minodori/spotmicro-pi/study/README.md

# 개발 일지 — 11주

결과물만으로는 전달되지 않는 시행착오의 맥락이 여기 있습니다. 서보를 잘못 고른 일,
전원 설계를 두 번 바꾼 일, 제어보드가 고장나 교체한 일이 그대로 남아 있습니다.

| 폴더 | 기간 | 내용 |
|---|---|---|
| [`minho/`](minho/) | work01~12 | 서보 선정, 조립, 전원 재설계, PCA9685 핀맵, **실측 기반 기구학 정정**, 4B 전환 |

가장 값이 큰 기록은 work10 입니다. 공개 코드의 다리 길이와 실물이 다르다는 것을
캘리퍼스로 확인한 회차이고, 이 저장소가 하는 일의 출발점입니다.

## 함께 작업한 사람들

이 로봇은 스터디에서 시작했습니다. 봄·여름 학기 참여자들의 기구학·보행 작업과
MuJoCo 학습 파이프라인이 기반이 되었습니다. 그 기록은 원 저장소에 있습니다.

- [orocapangyo/SpotMicroJetson](https://github.com/orocapangyo/SpotMicroJetson) — 스터디 저장소

계보와 라이선스 경계는 저장소 최상위 [`NOTICE`](../NOTICE) 에 적었습니다.
