minodori/spotmicro-pi/Images/README.md

# Images — upstream 데모 미디어

이 디렉터리의 사진과 GIF 는 **upstream(Road-Balance / FlorianWilk) 프로젝트의
로봇**을 담은 것으로, 본 팀이 제작한 로봇이 아닙니다. upstream README 가 참조하고
있어 그대로 보존합니다.

**본 팀이 촬영·제작한 미디어는 [`docs/media/`](../docs/media/) 에 있습니다.**
