minodori/spotmicro-pi/docs/media/README.md

# docs/media — 본 팀 로봇 미디어

본 팀이 제작한 로봇의 촬영본과 데모 미디어. `Images/` 의 upstream 데모와 구분됩니다.

대용량 영상은 저장소에 커밋하지 않고 GitHub 이슈에 업로드해 URL 로 참조합니다.
README 상단용 짧은 GIF(3MB 이하)만 여기에 둡니다.
