minodori/spotmicro-pi/docs/media/architecture.png

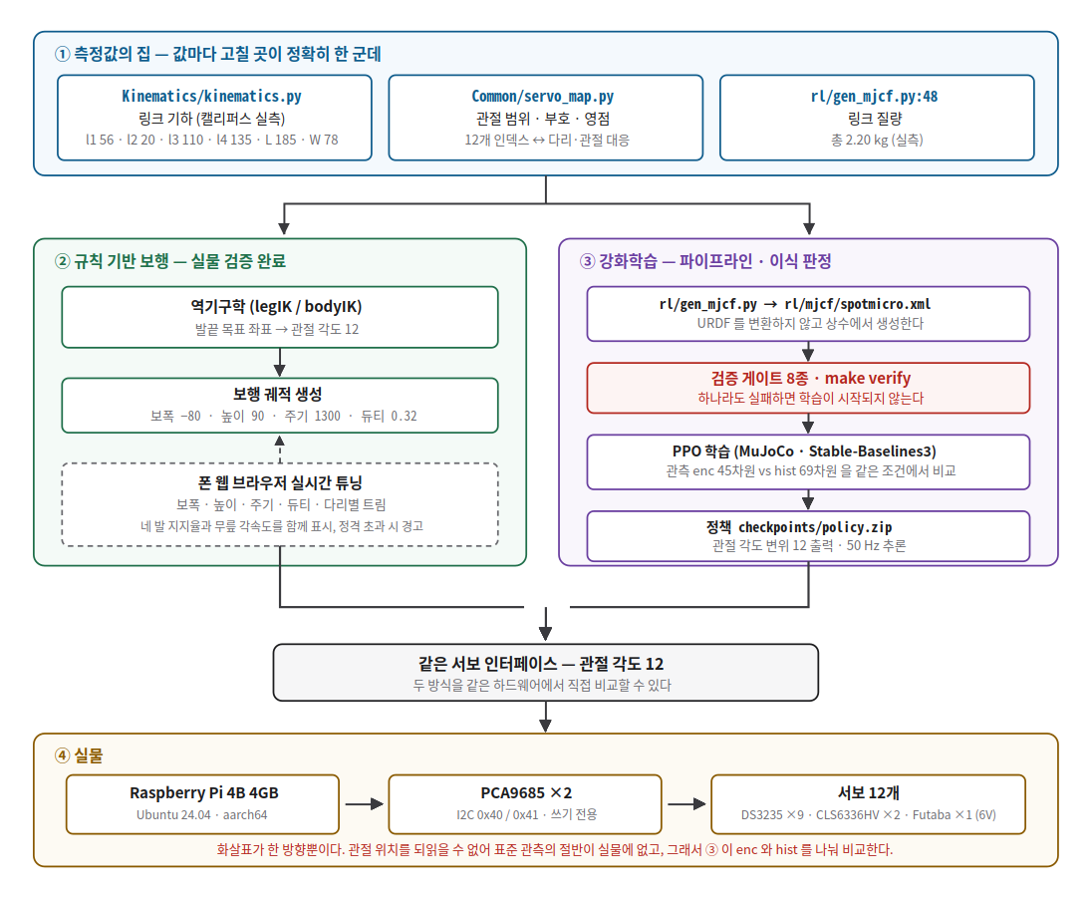
docs/media/architecture.png
