minodori/spotmicro-pi/docs/media/cut3_purpose.png

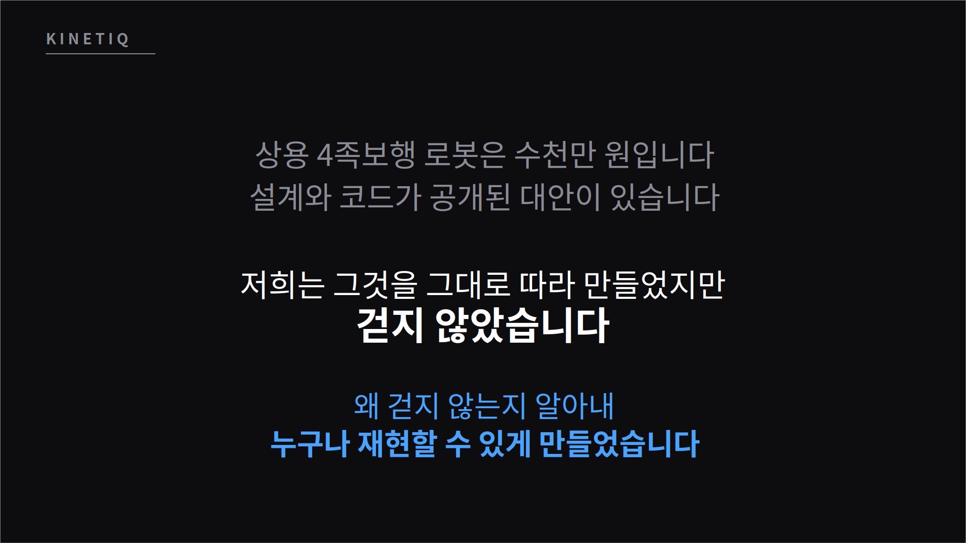
docs/media/cut3_purpose.png
