minodori/spotmicro-pi/docs/media/cut11_pipeline.png

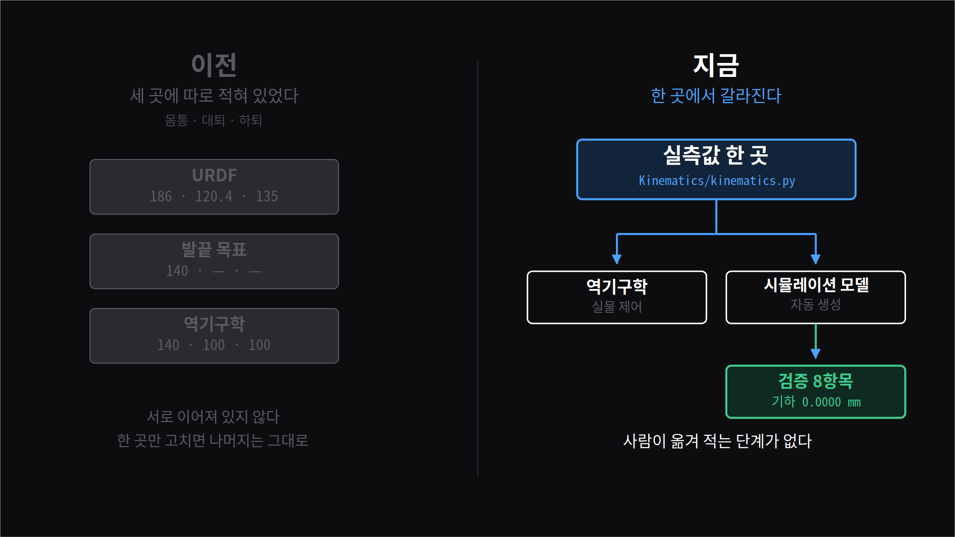
docs/media/cut11_pipeline.png
