minodori/spotmicro-pi/docs/media/cut20_three.png

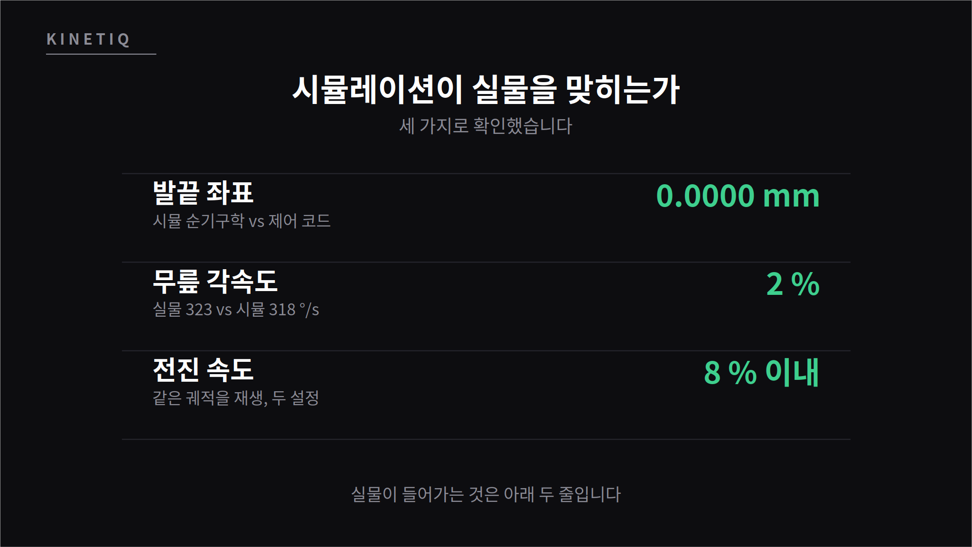
docs/media/cut20_three.png
