minodori/spotmicro-pi/docs/media/cut22_ending.png

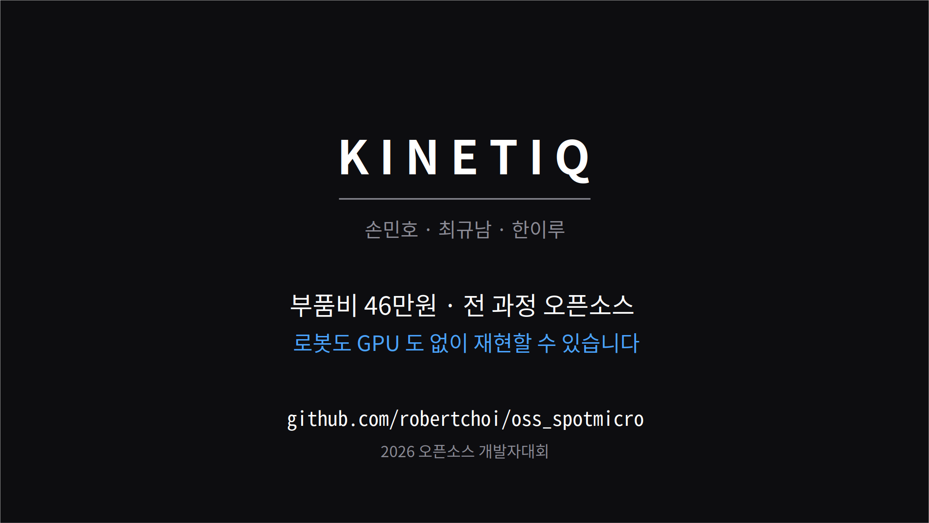
docs/media/cut22_ending.png
