minodori/spotmicro-pi/docs/media/templates/card_kinetiq_bottom.png

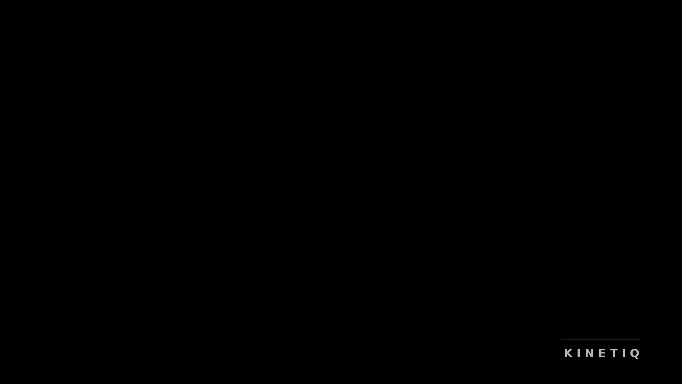
docs/media/templates/card_kinetiq_bottom.png
