minodori/spotmicro-pi/Simulation/image/keyboard_control.gif

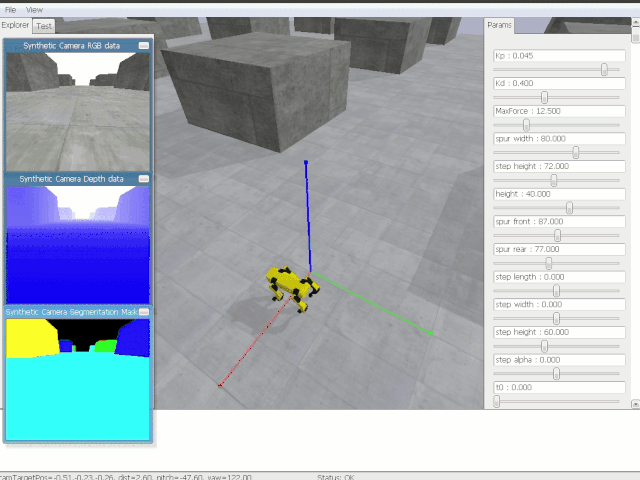
Simulation/image/keyboard_control.gif
