minodori/spotmicro-pi/study/minho/images/diagram_v1.0.png

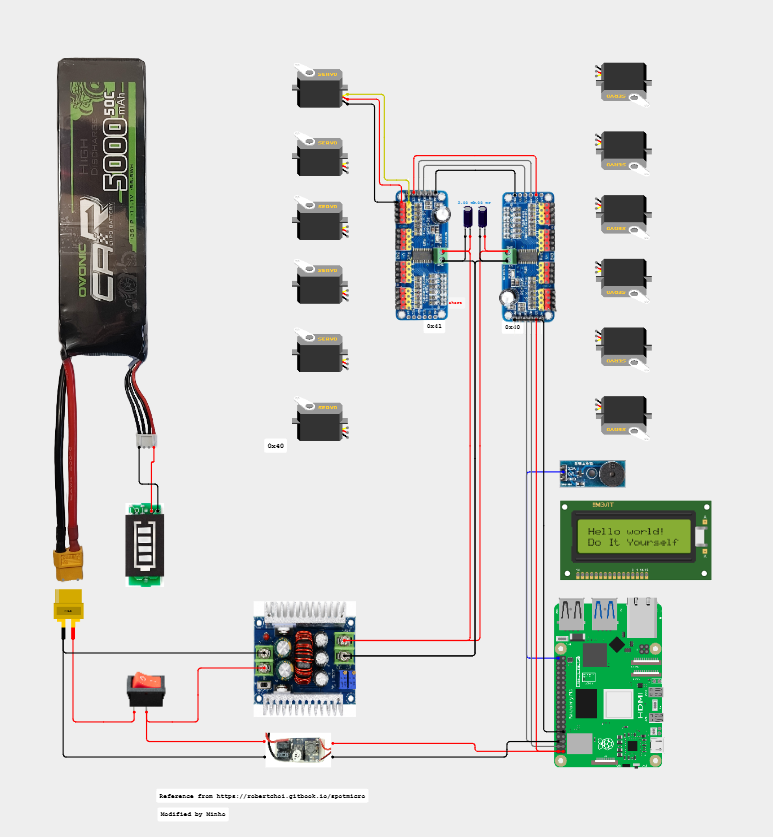
study/minho/images/diagram_v1.0.png
