minodori/spotmicro-pi/study/minho/stl/plate_rpi.png

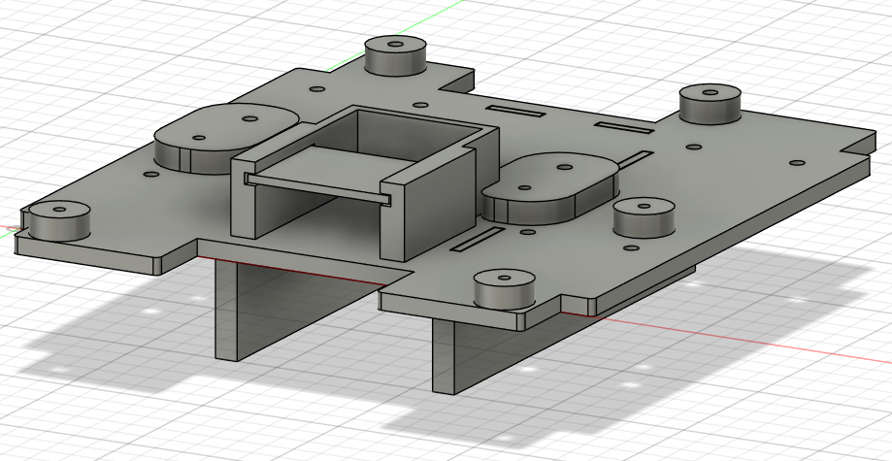
study/minho/stl/plate_rpi.png
