minodori/spotmicro-pi/Parts/rearmain.stl

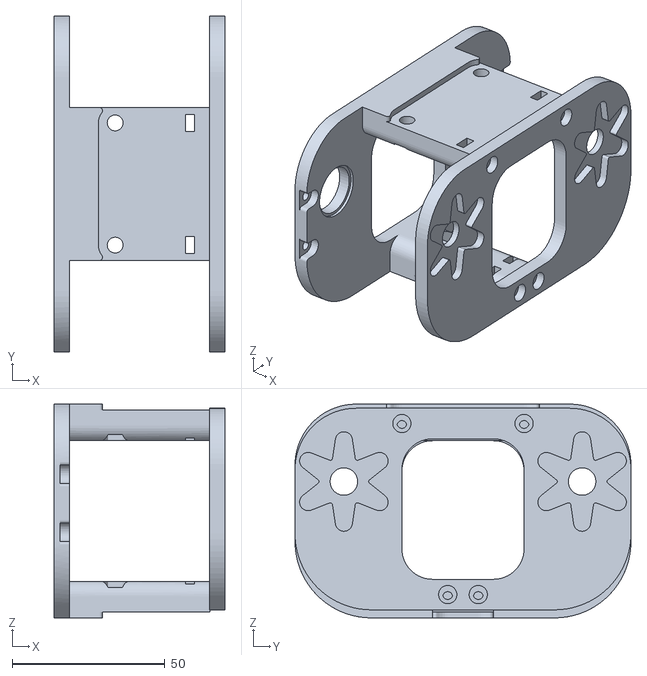
[picture p95: CAD file, 2020-09-26]
Parts/rearmain.stl
55.9 x 110.0 x 70.0
