minodori/spotmicro-pi/STL/lidar/rplidar_main.STL

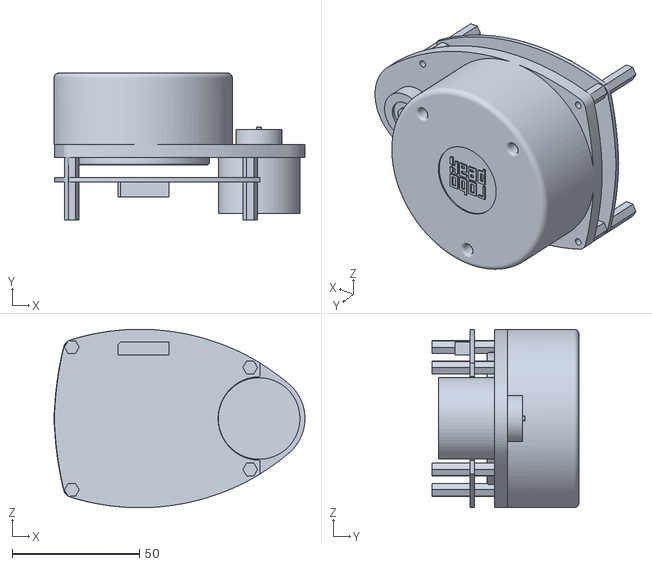
[picture p96: CAD file, 2020-09-26]
STL/lidar/rplidar_main.STL
98.5 x 57.7 x 70.0
