minodori/spotmicro-pi/Parts/mainbody.stl

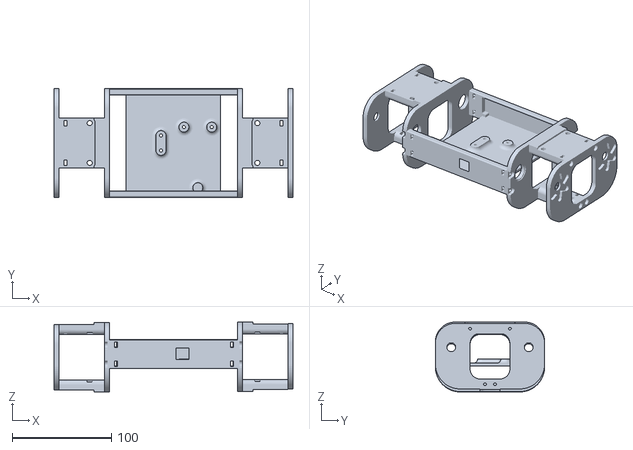
[picture p97: CAD file, 2020-09-26]
Parts/mainbody.stl
240.7 x 110.0 x 70.4
