minodori/spotmicro-pi/STEP_Files/I_shoulder_cls_modi.stp

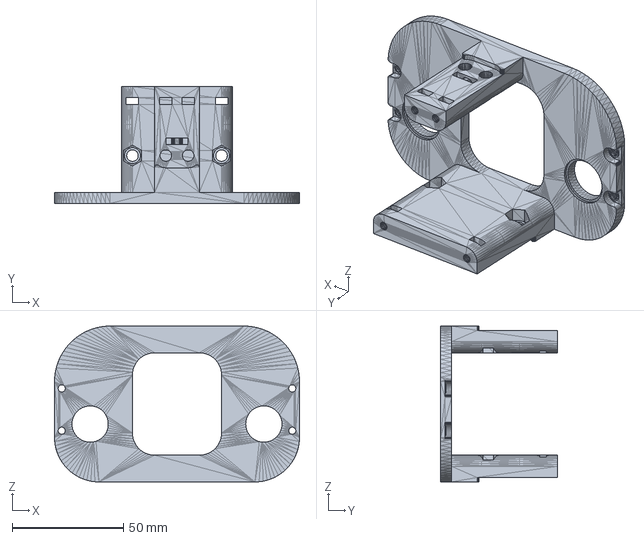
[picture p98: CAD file, 2021-01-22]
STEP_Files/I_shoulder_cls_modi.stp
110.0 x 52.5 x 70.0 mm
