minodori/spotmicro-pi/STL/files/L_arm_joint.3mf

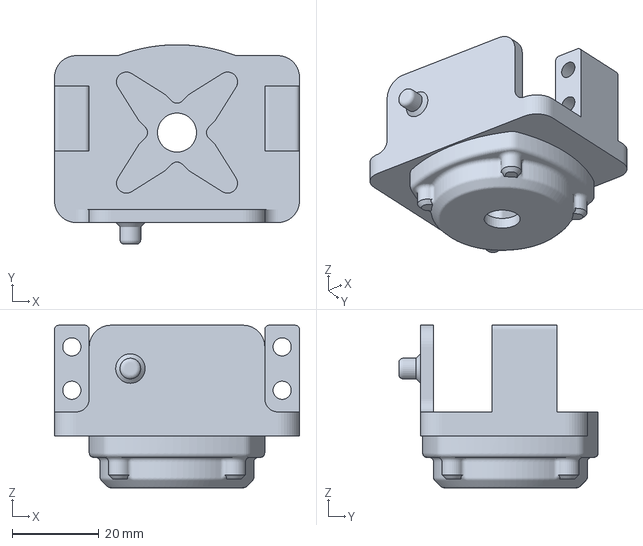
[picture p99: CAD file, 2026-09-12]
STL/files/L_arm_joint.3mf
56.5 x 46.0 x 37.5 mm
