minodori/spotmicro-pi/STL/rear2.stl

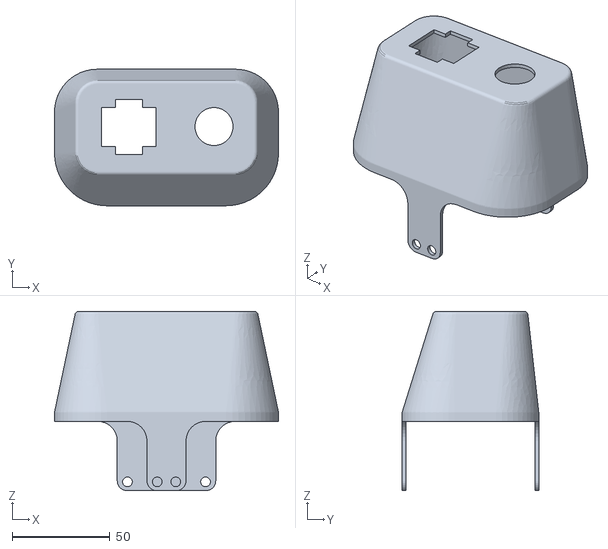
[picture p100: CAD file, 2020-09-26]
STL/rear2.stl
114.8 x 70.0 x 91.9
