minodori/spotmicro-pi/study/minho/stl/plate_ubec.stl

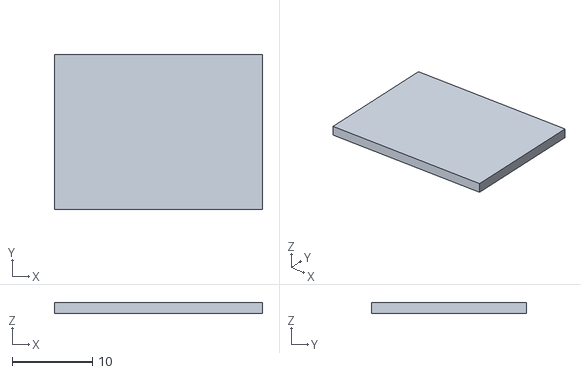
[picture p101: CAD file, 2026-08-20]
study/minho/stl/plate_ubec.stl
26.0 x 19.4 x 1.40
