minodori/spotmicro-pi/urdf/FreeCAD/SpotMicroAI_AdditionalParts.FCStd

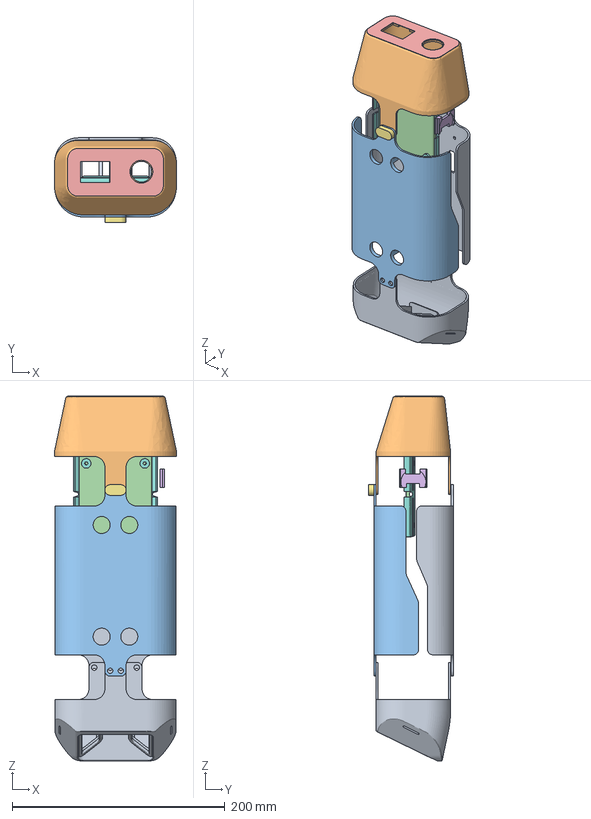
[picture p102: CAD file, 2020-09-26]
urdf/FreeCAD/SpotMicroAI_AdditionalParts.FCStd
114.8 x 79.5 x 343.2 mm
Top
Rear
Bottom
BatteryHolderHolder
rearlabel
LEDMount
ScrewGuard
F_cover
