minodori/spotmicro-pi/Parts/lshoulder.stl

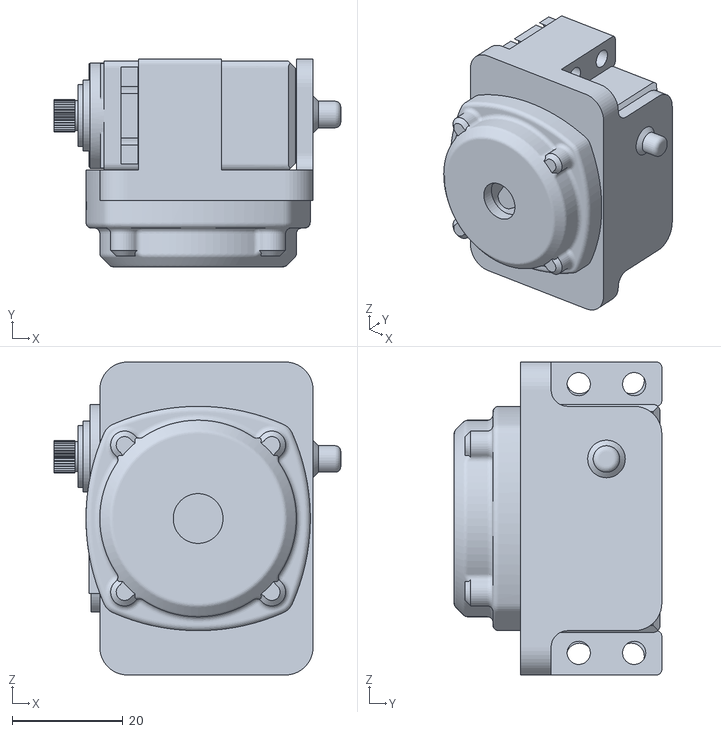
[picture p103: CAD file, 2020-09-26]
Parts/lshoulder.stl
51.7 x 37.5 x 56.5
