minodori/spotmicro-pi/STEP_Files/Bottom_modi(long).stp

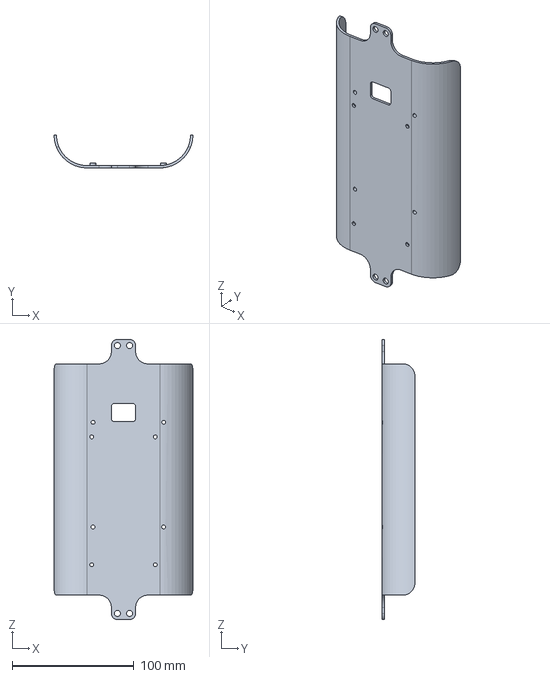
[picture p104: CAD file, 2021-01-22]
STEP_Files/Bottom_modi(long).stp
114.0 x 27.0 x 230.0 mm
