minodori/spotmicro-pi/STL/batteryholder2.stl

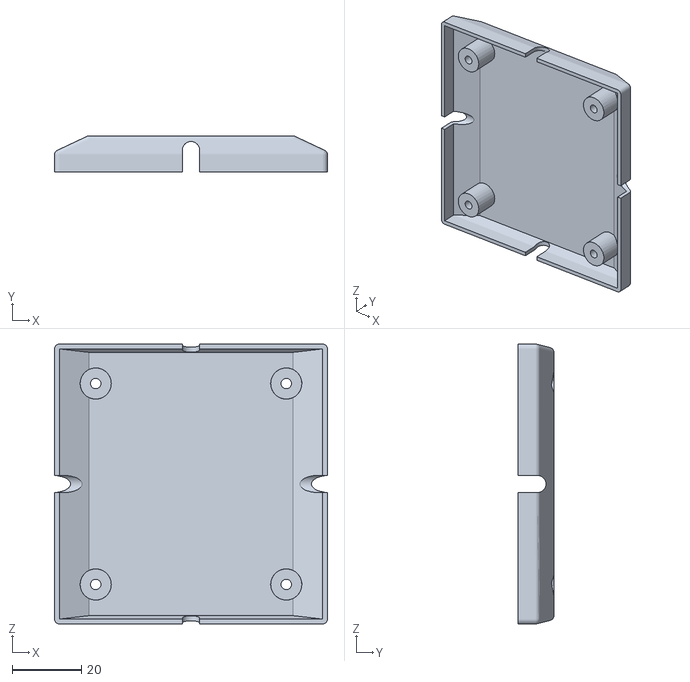
[picture p105: CAD file, 2020-09-26]
STL/batteryholder2.stl
78.8 x 10.4 x 80.8
