minodori/spotmicro-pi/STL/files/R_side_plate.stl

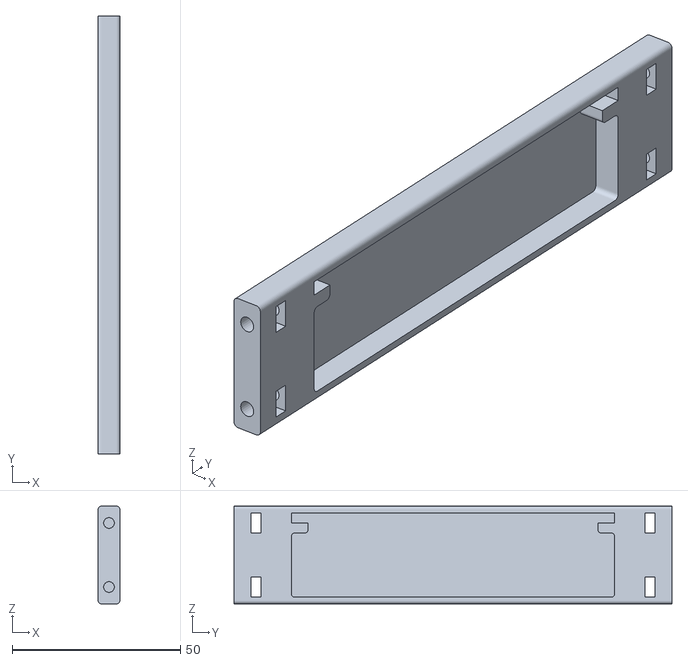
[picture p106: CAD file, 2020-09-26]
STL/files/R_side_plate.stl
6.50 x 130.0 x 29.0
