minodori/spotmicro-pi/study/minho/stl/plate_batt.stl

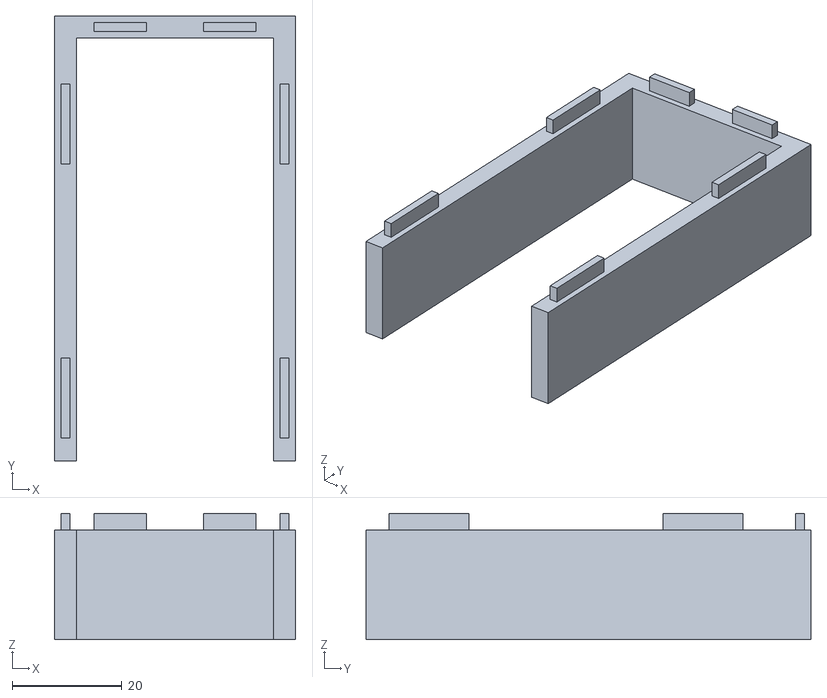
[picture p107: CAD file, 2026-08-20]
study/minho/stl/plate_batt.stl
44.0 x 81.2 x 23.0
