minodori/spotmicro-pi/urdf/FreeCAD/SpotMicroAI_JetsonParts.FCStd

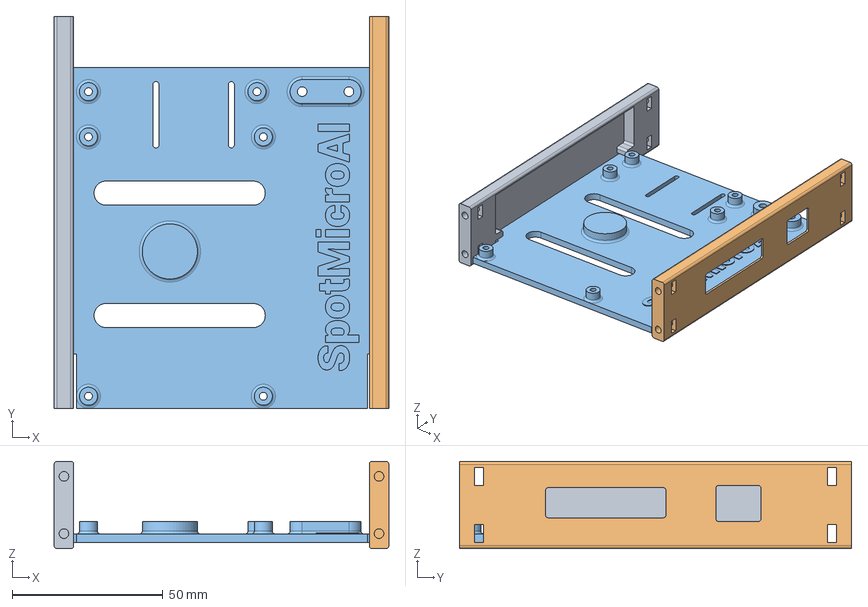
[picture p108: CAD file, 2020-09-26]
urdf/FreeCAD/SpotMicroAI_JetsonParts.FCStd
111.0 x 130.0 x 29.0 mm
rightSideplate
leftSideplate
JetsonPlateWithText
