minodori/spotmicro-pi/Parts/SpotMicroAI_Rear.FCStd

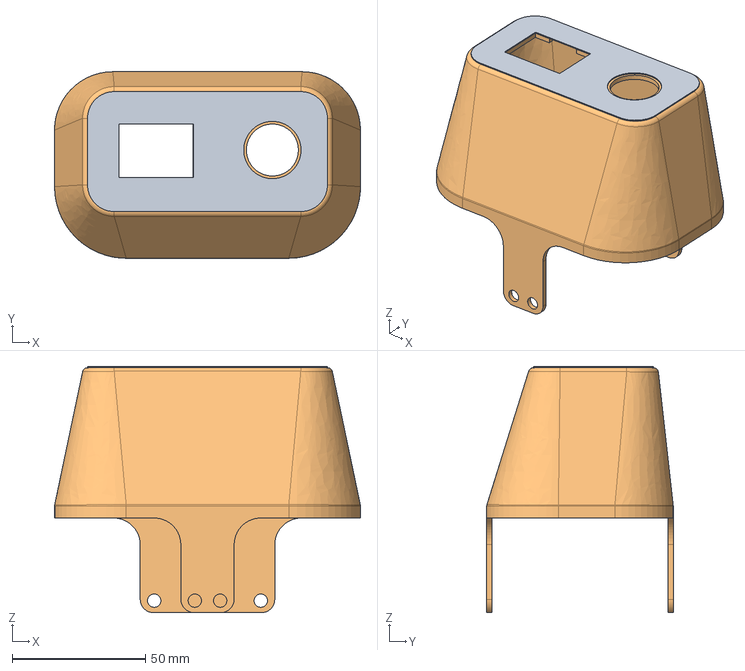
[picture p109: CAD file, 2020-09-26]
Parts/SpotMicroAI_Rear.FCStd
114.8 x 70.0 x 92.4 mm
rearlabel
Rear
