minodori/spotmicro-pi/STEP_Files/Top_modi(long).stp

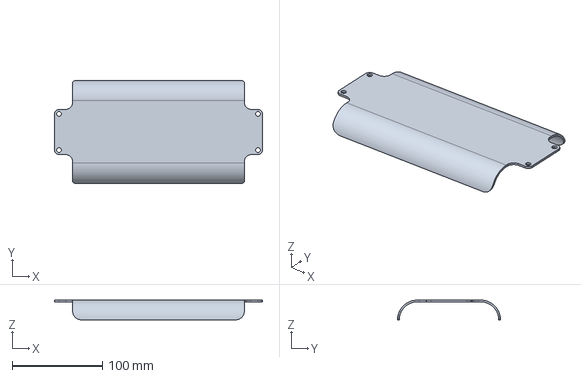
[picture p110: CAD file, 2021-01-22]
STEP_Files/Top_modi(long).stp
230.0 x 114.0 x 22.0 mm
