minodori/spotmicro-pi/STL/files/L_ultra_sonic.stl

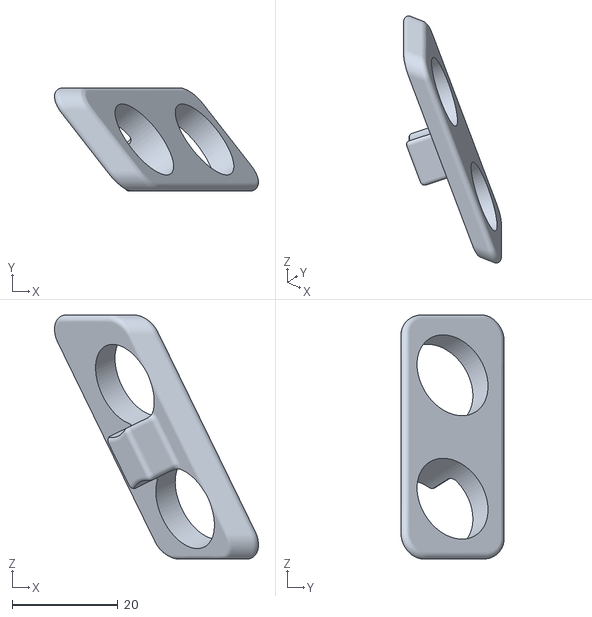
[picture p112: CAD file, 2020-09-26]
STL/files/L_ultra_sonic.stl
38.6 x 19.5 x 46.2
