minodori/spotmicro-pi/study/minho/stl/plate_rpi5.stl

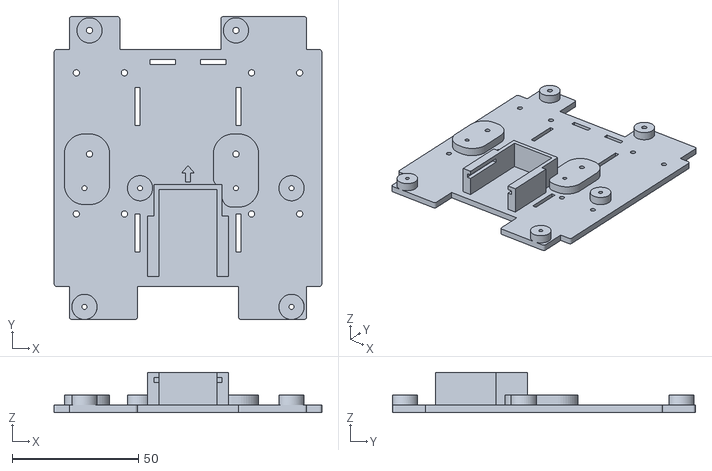
[picture p113: CAD file, 2026-08-20]
study/minho/stl/plate_rpi5.stl
106.0 x 120.0 x 16.0
