minodori/spotmicro-pi/STEP_Files/O_shoulder_cls_grooved_modi.stp

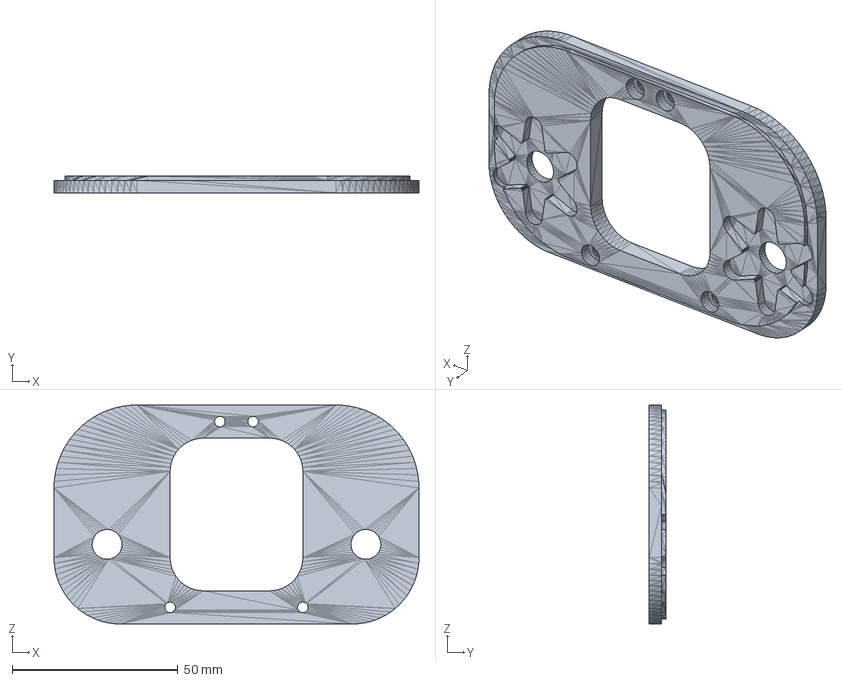
[picture p116: CAD file, 2021-01-22]
STEP_Files/O_shoulder_cls_grooved_modi.stp
110.0 x 5.00 x 66.0 mm
