minodori/spotmicro-pi/STL/top.stl

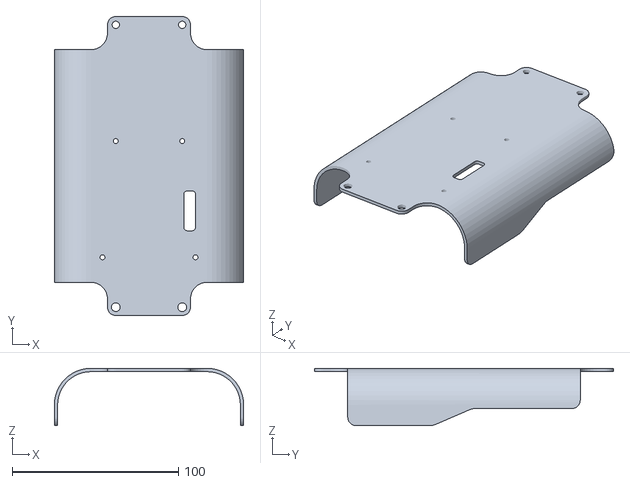
[picture p117: CAD file, 2020-09-26]
STL/top.stl
114.0 x 180.0 x 34.5
