minodori/spotmicro-pi/study/minho/stl/Spot_Stand.stl

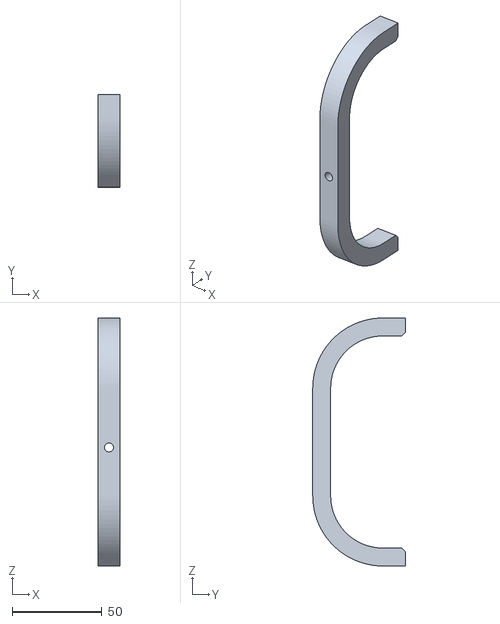
[picture p118: CAD file, 2026-07-01]
study/minho/stl/Spot_Stand.stl
12.0 x 51.5 x 138.0
