minodori/spotmicro-pi/STL/files/plate.stl

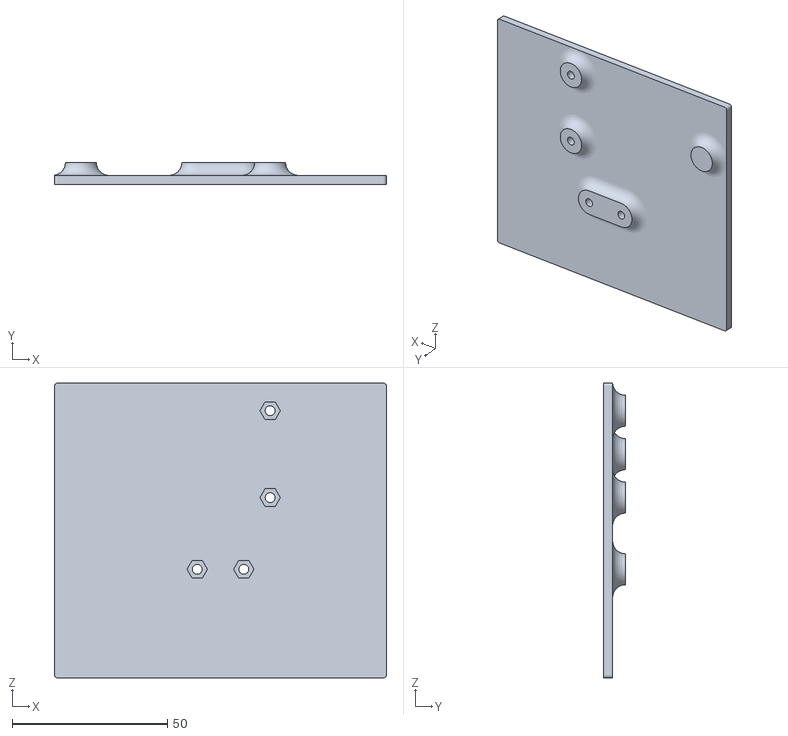
[picture p136: CAD file, 2020-09-26]
STL/files/plate.stl
107.0 x 7.00 x 95.0
