minodori/spotmicro-pi/Parts/jetsonPlate.stl

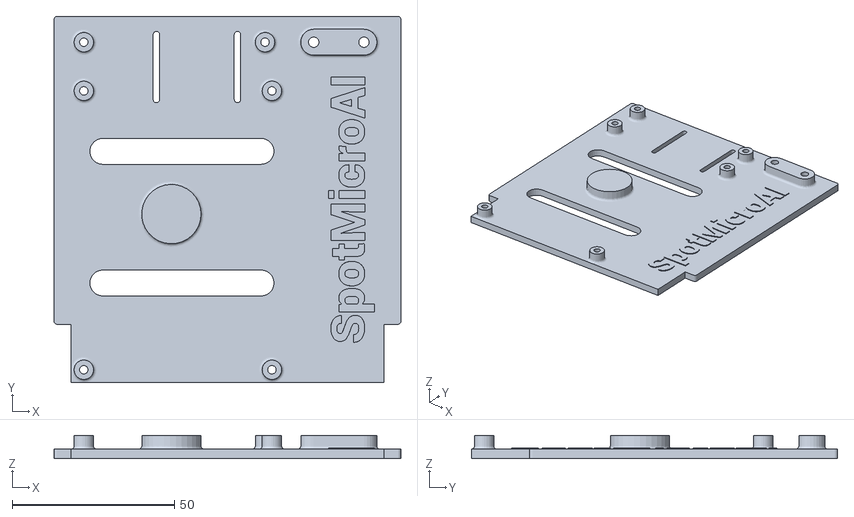
[picture p137: CAD file, 2020-09-26]
Parts/jetsonPlate.stl
107.0 x 113.0 x 7.10
