minodori/spotmicro-pi/(list of files, cad)

Other CAD files:
STL/files/non-mega_L_side_plate.stl
urdf/FreeCAD/SpotMicroAI_Bottom.FCStd
STL/files/R_arm_joint.stl
STL/rear.stl
STL/files/L_side_plate.stl
Parts/larm.stl
STL/files/R_ultra_sonic.stl
Parts/rshoulder.stl
STL/files/T_cover.stl
Parts/rfoot.stl
STL/files/R_wrist.stl
Parts/larm_cover.stl
STL/files/F_cover.stl
Parts/SpotMicroAI_Bottom.FCStd
STL/files/non-mega_B_cover.stl
STL/files/F_shoulder.stl
Parts/spotmicroai.blend
STL/files/L_arm.stl
STL/files/L_arm_cover.stl
STL/files/L_arm_joint.stl
STL/files/R_arm.stl
STL/files/R_arm_cover.stl
STL/files/R_shoulder.stl
STL/screwguard.stl
