minodori/spotmicro-pi/(list of files, drawings)

Other design files:
docs/hardware/circuit_diagram_v1.0.fzz
docs/hardware/circuit_diagram_v1.1.fzz
docs/Untitled Sketch 2.fzz
