minodori/spotmicro-pi/Common/web_control.py

"""보행 파라미터 조정용 웹 UI.

로봇을 보면서 조작해야 하는데 터미널을 동시에 볼 수 없다는 문제를 푼다.
폰으로 http://<로봇IP>:8080 에 접속하면 손에 들고 조작할 수 있다.

제어 루프(39Hz)는 건드리지 않는다. 데몬 스레드로 HTTP 서버를 띄우고
기존 command_status 큐를 키보드 입력과 같이 쓴다.
표준 라이브러리만 사용하므로 로봇에 추가 패키지가 필요 없다.
"""
import json
import subprocess
import threading
from http.server import BaseHTTPRequestHandler, ThreadingHTTPServer

from Common.gait_params import DEFAULTS
from Common.servo_map import SERVO_RATED_SLEW
from Common.multiprocess_kb import TWIST_WARN_RATIO

LEGS = ("FL", "FR", "RL", "RR")

PAGE = """<!doctype html><html lang="ko"><head>
<meta charset="utf-8"><meta name="viewport" content="width=device-width,initial-scale=1">
<title>SpotMicro</title><style>
*{box-sizing:border-box}
body{margin:0;padding:10px;font:15px/1.4 system-ui,sans-serif;background:#15171c;color:#e8e8ea}
h2{margin:4px 0 10px;font-size:16px;font-weight:600}
.grid{display:grid;grid-template-columns:1fr 1fr;gap:8px;margin-bottom:12px}
.leg{background:#22252c;border-radius:10px;padding:10px;text-align:center}
.leg .n{font-size:12px;color:#9aa0aa}
.leg .v{font-size:26px;font-weight:700;margin:2px 0 6px;font-variant-numeric:tabular-nums}
button{font:inherit;color:#e8e8ea;background:#333842;border:0;border-radius:8px;
 padding:12px 0;width:46%;font-size:19px;font-weight:700;cursor:pointer;touch-action:manipulation}
button:active{background:#4a5261}
.row{display:flex;gap:8px;align-items:center;margin:8px 0}
.row label{width:74px;color:#9aa0aa;font-size:13px}
.row input[type=range]{flex:1}
.row .rv{width:56px;text-align:right;font-variant-numeric:tabular-nums}
.bar{display:flex;gap:8px;margin:10px 0}
.bar button{width:auto;flex:1;padding:14px 0}
.pad{display:grid;grid-template-columns:1fr 1fr 1fr;gap:8px;margin:10px 0}
.pad button{width:100%;padding:16px 0;font-size:17px}
.stop{background:#7a2b2b}
.warn{background:#6b4a13;border-radius:8px;padding:8px;margin:8px 0;font-size:13px;display:none}
.hint{color:#7d838d;font-size:12px;margin:-4px 0 10px 82px}
.hint2{color:#7d838d;font-size:12px;margin:-4px 0 10px 2px}
.sub{font-weight:400;color:#9aa0aa;font-size:13px}
.st{background:#22252c;border-radius:10px;padding:10px;font-size:13px;color:#9aa0aa}
.st b{color:#e8e8ea;font-variant-numeric:tabular-nums}
.sw{position:fixed;right:10px;bottom:10px;background:#22252c;border:1px solid #333842;
 border-radius:12px;padding:8px 12px;text-align:right;cursor:pointer;
 box-shadow:0 2px 12px rgba(0,0,0,.5);touch-action:manipulation;z-index:9}
.sw .t{font-size:30px;font-weight:700;font-variant-numeric:tabular-nums;line-height:1.05}
.sw .d{font-size:11px;color:#7d838d;margin-top:2px}
.sw.run .t{color:#6bc47d}
</style></head><body>

<h2>다리별 트림 (mm)</h2>
<div class="grid" id="legs"></div>
<div class="warn" id="warn"></div>

<h2>기울기 <span class="sub" id="tilt"></span></h2>
<div class="bar">
 <button onclick="cmd({mode:'pitch',delta:1})">앞으로 숙임</button>
 <button onclick="cmd({mode:'pitch',delta:-1})">뒤로 젖힘</button>
</div>
<div class="hint2">무게중심이 뒤로 쏠려 있으면 앞으로 숙여 앞다리에 하중을 옮긴다. 1mm 당 약 0.7%p.</div>
<div class="bar">
 <button onclick="cmd({mode:'roll',delta:1})">왼쪽 낮춤</button>
 <button onclick="cmd({mode:'roll',delta:-1})">오른쪽 낮춤</button>
</div>

<div class="bar">
 <button onclick="cmd({reset:'trim'})">트림 0 으로</button>
 <button onclick="cmd({reset:'all'})">전체 기본값</button>
</div>

<div class="row"><label>몸통 높이</label>
 <input type="range" id="height" step="1"><span class="rv" id="heightv"></span></div>
<div class="hint">어깨축~발바닥 = 140 + 이 값. 무릎내각 110도가 96, 120도가 108, 130도가 118.</div>
<div class="row"><label>발 들어올림</label>
 <input type="range" id="Sh" step="1"><span class="rv" id="Shv"></span></div>
<div class="hint">스윙 중 발이 지면에서 뜨는 높이. 작으면 발이 끌리고, 크면 무릎이 궤적을 못 따라간다.</div>
<div class="row"><label>주기</label>
 <input type="range" id="Tt" step="50"><span class="rv" id="Ttv"></span></div>
<div class="hint">한 걸음 주기(ms). 전진 속도 = 보폭 / 주기 이므로 이것만 속도를 정한다.</div>
<div class="row"><label>스윙 비율</label>
 <input type="range" id="duty" step="0.01"><span class="rv" id="dutyv"></span></div>
<div class="hint">주기 중 발이 떠 있는 비율. 이것만 네발지지를 정한다 (= 1 − 2 × 비율).
 <b>올리지 마세요.</b> 0.21(네발지지 58%)에서 뒤로 넘어진 기록이 있습니다.
 발을 높이 들려면 이 값이 아니라 <b>주기</b>를 올리세요.</div>

<h2>보행</h2>
<div class="pad">
 <div></div>
 <button onclick="step('w')">전진</button>
 <div></div>
 <button onclick="step('a')">◀ 좌</button>
 <button class="stop" onclick="cmd({stop:1})">정지</button>
 <button onclick="step('d')">우 ▶</button>
 <div></div>
 <button onclick="step('s')">후진</button>
 <div></div>
</div>
<div class="bar">
 <button onclick="step('q')">↺ 좌회전</button>
 <button onclick="step('e')">우회전 ↻</button>
</div>
<div class="hint2">누를 때마다 누적된다. 전후 10mm, 좌우 10mm, 회전 3도.</div>

<div class="st">
 보폭 <b id="sl">-</b>mm &nbsp; 좌우 <b id="sw">-</b>mm &nbsp; 회전 <b id="sa">-</b>°<br>
 <b id="mode">-</b> &nbsp; 대각 차이 <b id="spread">-</b>mm<br>
 네발지지 <b id="sup">-</b>% &nbsp; 무릎슬루 <b id="slew">-</b>°/s (정격 <b id="rated">-</b>)<br>
 전진 <b id="spd">-</b>mm/s <span style="font-size:11px">이론값 — 실제 속도는 줄자로 재야 합니다</span>
</div>

<div class="sw" id="sw" onclick="swReset()">
 <div class="t" id="swt">0.0</div>
 <div class="d" id="swd">탭 = 0 부터</div>
</div>

<h2>전원</h2>
<div class="bar">
 <button class="stop" id="pwrBtn" onclick="togglePower()">서보 끄기</button>
 <button class="stop" onclick="piShutdown()">Pi 끄기</button>
</div>
<div class="hint2">서보 끄기: 명령 전송만 멈춘다 (이 페이지는 계속 켜져 있다). Pi 끄기:
 라즈베리파이 전체 종료 - 다시 켜려면 전원을 뽑았다 꽂아야 한다.</div>

<script>
const L=["FL","FR","RL","RR"];
// 슬라이더 -> 표시 소수 자릿수. 범위와 step 은 서버가 /state 로 내려준다.
const SLIDERS={height:0,Sh:0,Tt:0,duty:2};
document.getElementById("legs").innerHTML=L.map((n,i)=>
 `<div class="leg"><div class="n">${n}</div><div class="v" id="t${i}">0</div>
  <button onclick="leg('${n}',1)">▲</button>
  <button onclick="leg('${n}',-1)">▼</button></div>`).join("");

async function post(b){
 try{const r=await fetch("/cmd",{method:"POST",body:JSON.stringify(b)});draw(await r.json());}
 catch(e){}
}
// 스톱워치. 20초 주행 거리를 재려면 로봇을 보면서 시간을 봐야 하는데,
// 별도 앱을 띄우면 화면을 오가게 된다. 조작하는 손에 시계가 같이 있어야 한다.
//
// 전진/후진을 누르면 시작하고 정지에서 멈춘다. 다만 보폭을 -70 까지 올리는
// 동안(w 7회) 이미 걷고 있으므로 그 구간이 섞인다. 탭하면 0 부터 다시 센다 -
// 보폭을 다 올린 뒤 한 번 탭하는 것이 실제 측정 시작점이다.
let swT0=null, swHold=0, lastState=null;
function swStart(){ if(swT0===null){ swT0=Date.now(); swHold=0; } }
function swStop(){ if(swT0!==null){ swHold=Date.now()-swT0; swT0=null; } }
function swReset(){ swT0=Date.now(); swHold=0; }
setInterval(()=>{
 const ms = swT0!==null ? Date.now()-swT0 : swHold;
 const sec = ms/1000;
 document.getElementById("swt").textContent=sec.toFixed(1);
 document.getElementById("sw").classList.toggle("run", swT0!==null);
 let d="탭 = 0 부터";
 if(lastState){
  // 이론 이동거리. 실측 거리와의 차이가 곧 미끄러짐이다.
  const v=Math.abs(lastState.IDstepLength)/lastState.Tt*1000;
  d=`이론 ${(v*sec/10).toFixed(0)}cm  ·  ${v.toFixed(0)}mm/s`;
 }
 document.getElementById("swd").textContent=d;
},100);

const cmd=b=>{ if(b&&b.stop) swStop(); return post(b); };
function togglePower(){
 const active = !lastState || lastState.ServoActive!==false;
 if(active && !confirm("서보 명령을 멈춥니다. 로봇이 지금 자세로 멈춥니다. 계속?")) return;
 post({active: !active});
}
function piShutdown(){
 if(!confirm("라즈베리파이 전원을 끕니다. 다시 켜려면 전원을 뽑았다 꽂아야 합니다. 계속?")) return;
 post({poweroff:1});
}
const leg=(n,d)=>post({leg:n,delta:d});
const step=k=>{ if(k==="w"||k==="s") swStart(); return post({key:k}); };

function draw(s){
 if(!s||!s.IDtrim)return;
 s.IDtrim.forEach((v,i)=>document.getElementById("t"+i).textContent=(v>0?"+":"")+v.toFixed(0));
 const t0=s.IDtrim;
 const twist=((t0[0]+t0[3])-(t0[1]+t0[2]))/4, gap=Math.abs(twist)*2;
 document.getElementById("spread").textContent=gap.toFixed(1);
 const w=document.getElementById("warn");
 let msg="";
 if(s.ikFail) msg="IK 도달 불가 - 서보 명령이 중단됩니다. 몸통을 낮추거나 보폭을 줄이세요.";
 else if(s.blocked&&s.blocked.length) msg="범위 초과로 전송 못 한 관절이 있습니다 ("+s.blocked.length+"개). 그 관절은 얼어붙습니다.";
 else if(gap>s.Sh*s.twistRatio) msg="대각 차이가 큽니다 ("+gap.toFixed(1)+"mm). 높은 대각 쌍이 접지하지 못할 수 있습니다.";
 else if(s.duty>0.175) msg="네발지지 "+(Math.max(0,1-2*s.duty)*100).toFixed(0)+"% - 뒤로 넘어질 수 있습니다. 발을 높이 들려면 스윙비율이 아니라 주기를 올리세요.";
 w.style.display=msg?"block":"none";
 w.textContent=msg;
 const t=s.IDtrim;
 const pitch=((t[0]+t[1])-(t[2]+t[3]))/4, roll=((t[0]+t[2])-(t[1]+t[3]))/4;
 document.getElementById("tilt").textContent=
  `앞뒤 ${pitch>0?"+":""}${pitch.toFixed(1)}  좌우 ${roll>0?"+":""}${roll.toFixed(1)} mm`;
 document.getElementById("sl").textContent=s.IDstepLength.toFixed(0);
 document.getElementById("sw").textContent=(s.IDstepWidth*2).toFixed(0);
 document.getElementById("sa").textContent=s.IDstepAlpha.toFixed(0);
 document.getElementById("mode").textContent=s.StartStepping?"보행중":"정지";
 document.getElementById("pwrBtn").textContent=s.ServoActive===false?"서보 켜기":"서보 끄기";
 lastState=s;
 if(!s.StartStepping) swStop();   // 로봇이 멈추면 시계도 멈춘다 (space, 넘어짐 등)
 for(const k in SLIDERS){
  const el=document.getElementById(k);
  if(s.ranges&&s.ranges[k]){el.min=s.ranges[k][0];el.max=s.ranges[k][1];}
  if(document.activeElement!==el)el.value=s[k];
  document.getElementById(k+"v").textContent=(+s[k]).toFixed(SLIDERS[k]);
 }
 // 파생값. 슬라이더를 움직이는 동안 이게 같이 움직여야 무엇을 하고 있는지 보인다.
 // 슬루는 제어 루프가 실측해 내려준다. 여기서 다시 계산하면 보폭을 놓친다.
 const t3=s.Tt*s.duty, sup=Math.max(0,1-2*s.duty)*100;
 const slew=(s.slew!==undefined)?s.slew:(t3>0?s.Sh*Math.PI/(t3/1000):0);
 document.getElementById("sup").textContent=sup.toFixed(0);
 document.getElementById("slew").textContent=slew.toFixed(0);
 document.getElementById("spd").textContent=(Math.abs(s.IDstepLength)/s.Tt*1000).toFixed(0);
 // 위험 구간을 색으로 알린다. 정격은 /state 가 내려준다 (Common/servo_map.py,
 // 6V 에서 500°/s). 페이지에 숫자를 적어두면 전압이 바뀔 때 여기만 남는다.
 // 네발지지 임계값은 실측이다. 50% 미만에서만 경고하다가 58% 에서 뒤로 넘어졌다
 // (2026-08-20, 스윙비율 0.21). work11 6.16.1 은 50% 에서 주저앉았다고 기록한다.
 // IMU 가 없어 로봇은 넘어진 것을 알지 못하므로 화면이 미리 알려야 한다.
 document.getElementById("sup").style.color=sup<55?"#e05050":sup<65?"#e0a030":"#e8e8ea";
 const rated=s.servoRatedSlew||500;
 document.getElementById("rated").textContent=rated.toFixed(0);
 document.getElementById("slew").style.color=slew>rated?"#e05050":slew>rated*0.9?"#e0a030":"#e8e8ea";
}
for(const k in SLIDERS){
 document.getElementById(k).addEventListener("input",e=>{
  document.getElementById(k+"v").textContent=(+e.target.value).toFixed(SLIDERS[k]);
  post({param:k,value:+e.target.value});
 });
}
setInterval(async()=>{try{draw(await(await fetch("/state")).json())}catch(e){}},400);
</script></body></html>"""


def startWebControl(keyInputs, port=8080):
    """HTTP 서버를 데몬 스레드로 띄운다. 실패해도 보행은 계속된다."""

    def state():
        s = keyInputs.snapshot()
        s['twistRatio'] = TWIST_WARN_RATIO
        s['servoRatedSlew'] = SERVO_RATED_SLEW
        # 슬라이더 범위를 여기서 내려준다. HTML 에 적어두면 DEFAULTS 와 어긋난다.
        s['ranges'] = {k: [lo, hi] for k, (_, lo, hi) in DEFAULTS.items() if lo is not None}
        s.update(getattr(keyInputs, 'runtime', {}))   # 제어 루프가 갱신하는 실시간 상태
        for k in DEFAULTS:
            s.setdefault(k, DEFAULTS[k][0])
        return s

    class Handler(BaseHTTPRequestHandler):
        protocol_version = "HTTP/1.1"

        def log_message(self, *a):
            pass        # 요청 로그가 화면과 gait.log 를 오염시키지 않도록 끈다

        def _send(self, body, ctype):
            data = body.encode()
            self.send_response(200)
            self.send_header("Content-Type", ctype)
            self.send_header("Content-Length", str(len(data)))
            self.send_header("Cache-Control", "no-store")
            self.end_headers()
            self.wfile.write(data)

        def do_GET(self):
            if self.path.startswith("/state"):
                self._send(json.dumps(state()), "application/json")
            elif self.path == "/" or self.path.startswith("/index"):
                self._send(PAGE, "text/html; charset=utf-8")
            else:
                self.send_error(404)

        def do_POST(self):
            try:
                n = int(self.headers.get("Content-Length", 0))
                req = json.loads(self.rfile.read(n) or b"{}")
            except (ValueError, TypeError):
                self.send_error(400)
                return

            if 'leg' in req and req['leg'] in LEGS:
                keyInputs.trimAdjust(req['leg'], 1 if req.get('delta', 1) > 0 else -1)
            elif 'param' in req:
                keyInputs.setParam(req['param'], req.get('value', 0))
            elif req.get('mode') in ('pitch', 'roll'):
                keyInputs.trimAdjust(req['mode'], 1 if req.get('delta', 1) > 0 else -1)
            elif req.get('reset') in ('trim', 'all'):
                keyInputs.resetParams(req['reset'])
            elif req.get('key') in ('w', 'a', 's', 'd', 'q', 'e'):
                keyInputs.keyCounter(req['key'])
                keyInputs.calcRbStep()
            elif req.get('stop'):
                keyInputs.resetStatus()
                keyInputs.calcRbStep()
            elif 'active' in req:
                keyInputs.setActive(req['active'])
            elif req.get('poweroff'):
                # 응답을 먼저 내보낸 뒤 끈다. Pi 전체가 내려가므로 프로세스도
                # 같이 죽는다 - 이후 systemd 재시작은 없다 (poweroff).
                threading.Timer(0.5, subprocess.run, args=(['sudo', 'systemctl', 'poweroff'],)).start()
            self._send(json.dumps(state()), "application/json")

    try:
        srv = ThreadingHTTPServer(("0.0.0.0", port), Handler)
    except OSError as e:
        print(f"웹 UI 를 열지 못했다 (포트 {port}): {e}")
        return None
    threading.Thread(target=srv.serve_forever, daemon=True).start()
    return srv
