minodori/spotmicro-pi/study/minho/images/Power_PreInstall_backside.JPG

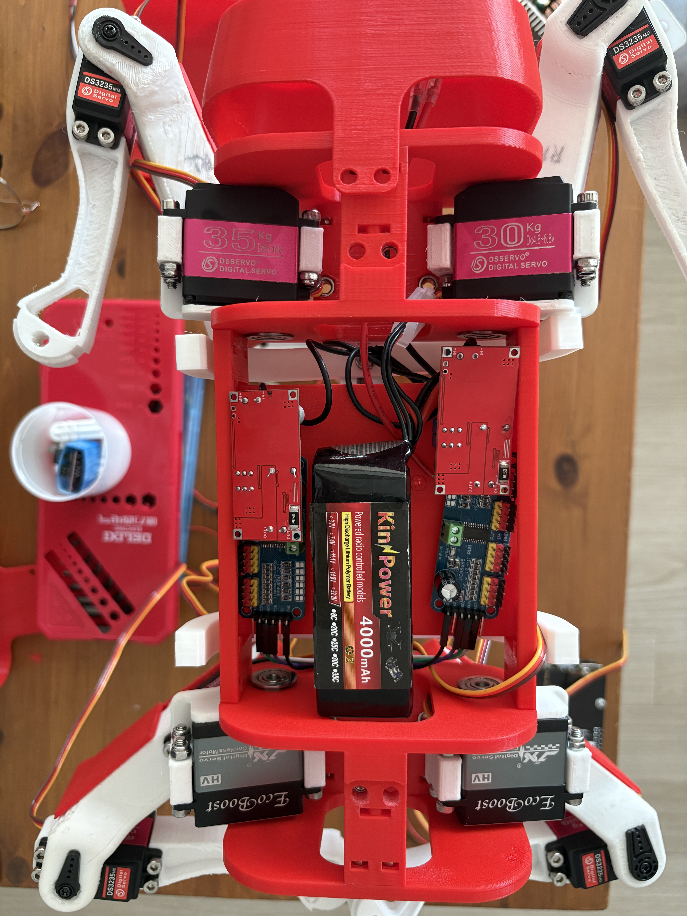
[picture p44: study/minho/images/Power_PreInstall_backside.JPG]
study/minho/images/Power_PreInstall_backside.JPG
