minodori/spotmicro-pi/study/minho/images/Power_block.JPG

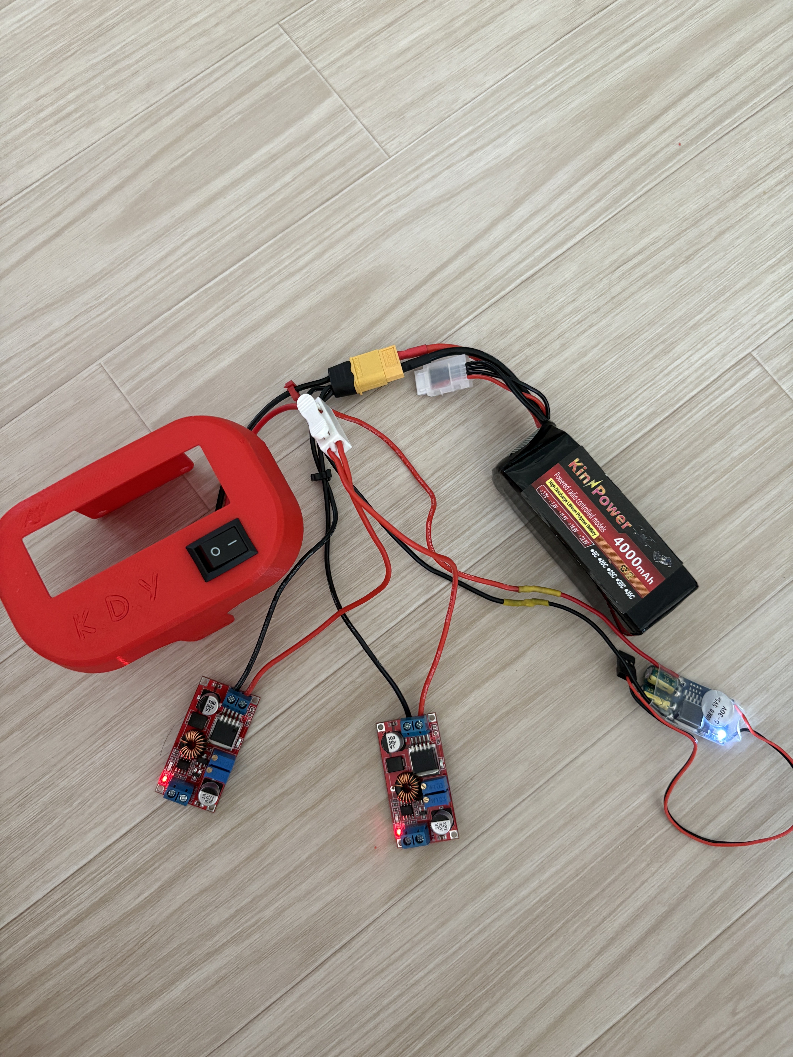
[picture p45: study/minho/images/Power_block.JPG]
study/minho/images/Power_block.JPG
