minodori/spotmicro-pi/study/minho/stl/Spot_Stand_img1.JPG

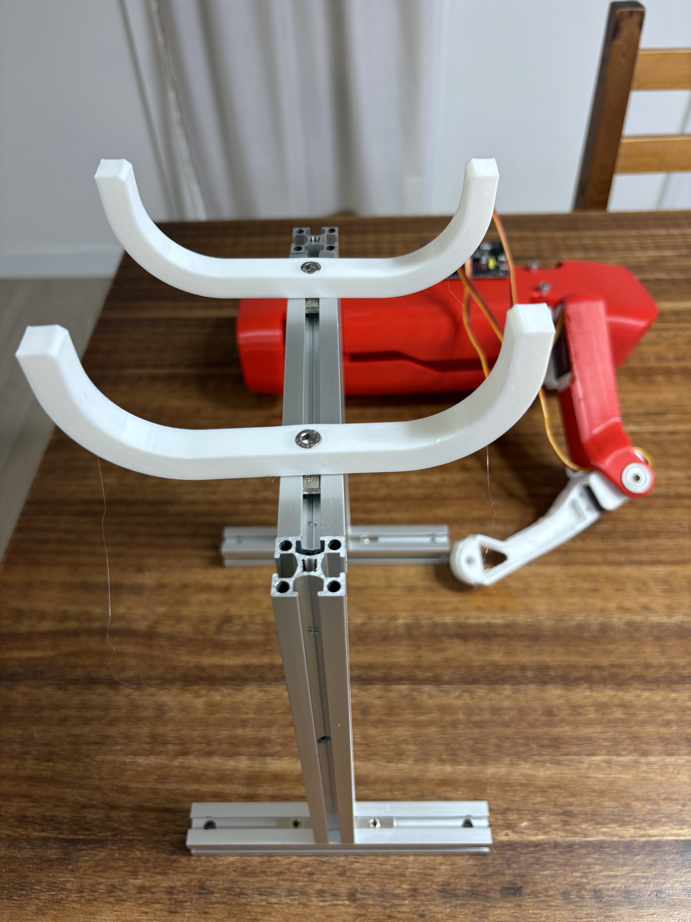
[picture p48: study/minho/stl/Spot_Stand_img1.JPG]
study/minho/stl/Spot_Stand_img1.JPG
