minodori/spotmicro-pi/study/minho/stl/Spot_Stand_img2.JPG

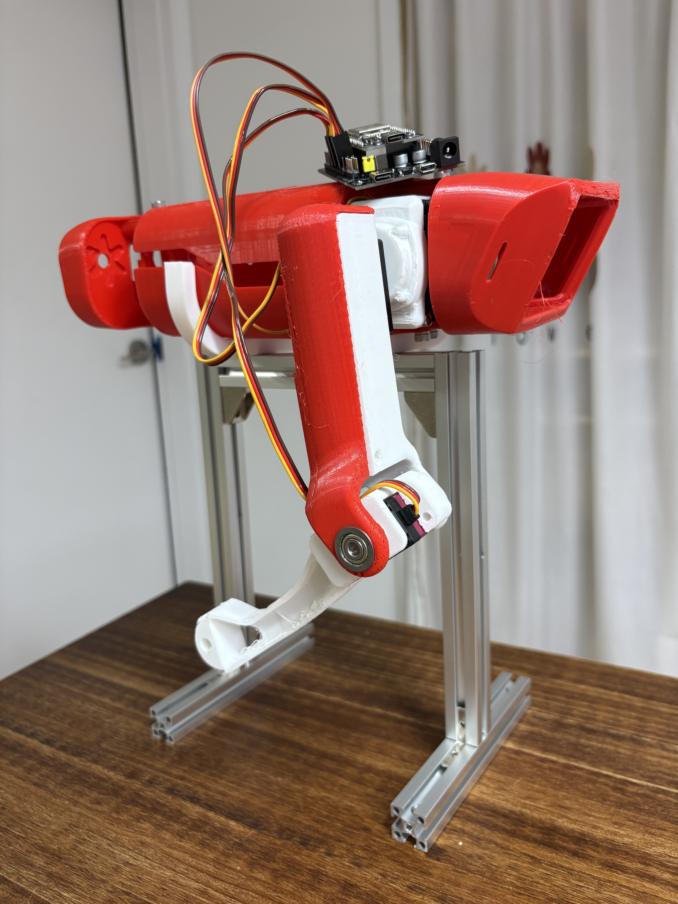
[picture p49: study/minho/stl/Spot_Stand_img2.JPG]
study/minho/stl/Spot_Stand_img2.JPG
