minodori/spotmicro-pi/study/minho/stl/Spot_Stand_img3.JPG

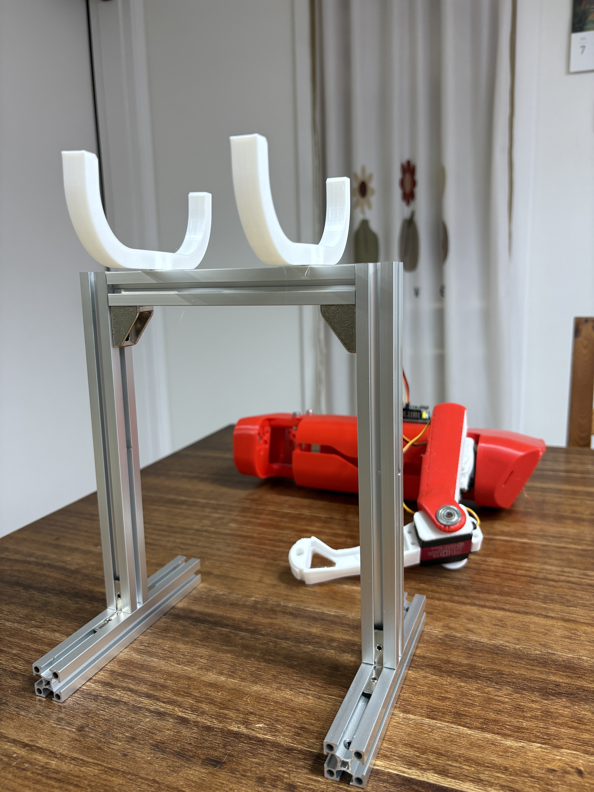
[picture p50: study/minho/stl/Spot_Stand_img3.JPG]
study/minho/stl/Spot_Stand_img3.JPG
