minodori/spotmicro-pi/study/minho/stl/Spot_Stand_img4.JPG

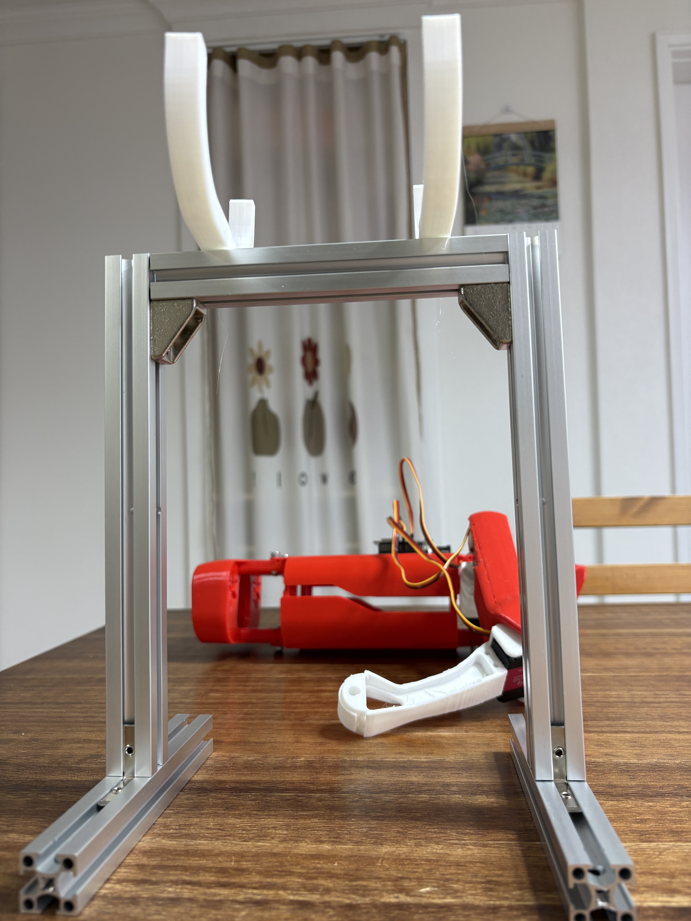
[picture p51: study/minho/stl/Spot_Stand_img4.JPG]
study/minho/stl/Spot_Stand_img4.JPG
