minodori/spotmicro-pi/study/minho/stl/assy_plate_rpi_front.JPEG

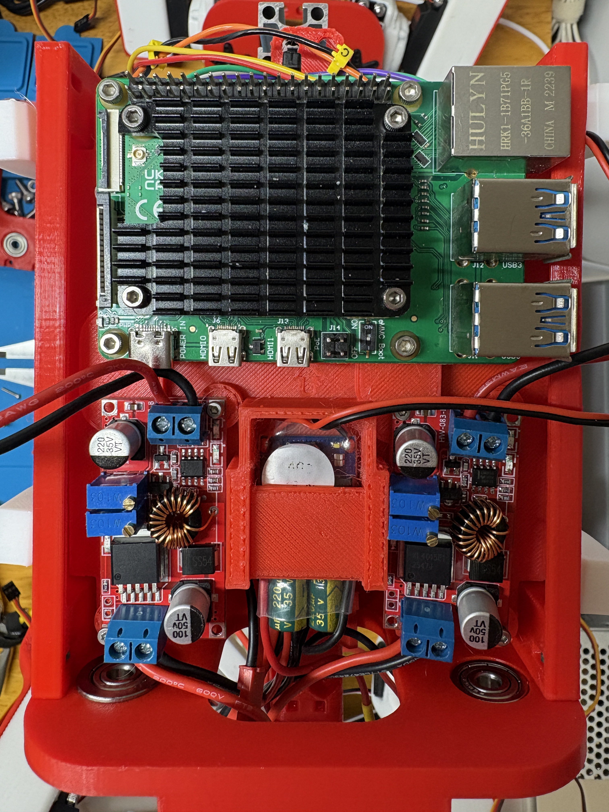
study/minho/stl/assy_plate_rpi_front.JPEG
