minodori/spotmicro-pi/study/minho/stl/assy_plate_rpi_rear.JPEG

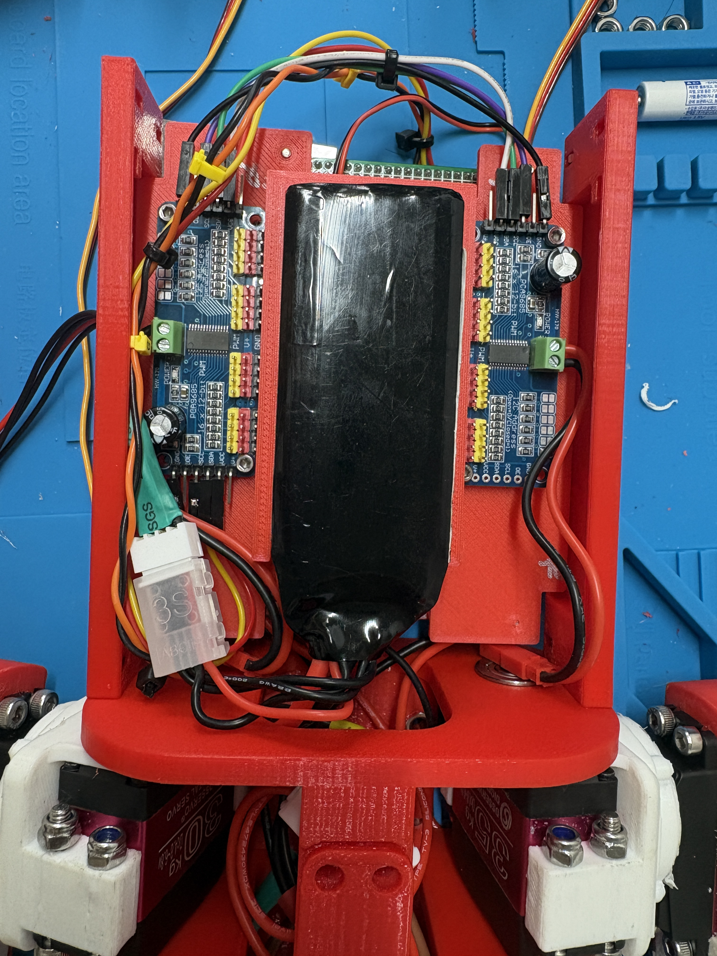
study/minho/stl/assy_plate_rpi_rear.JPEG
