minodori/spotmicro-pi/study/minho/stl/plate_rpi_front.JPG

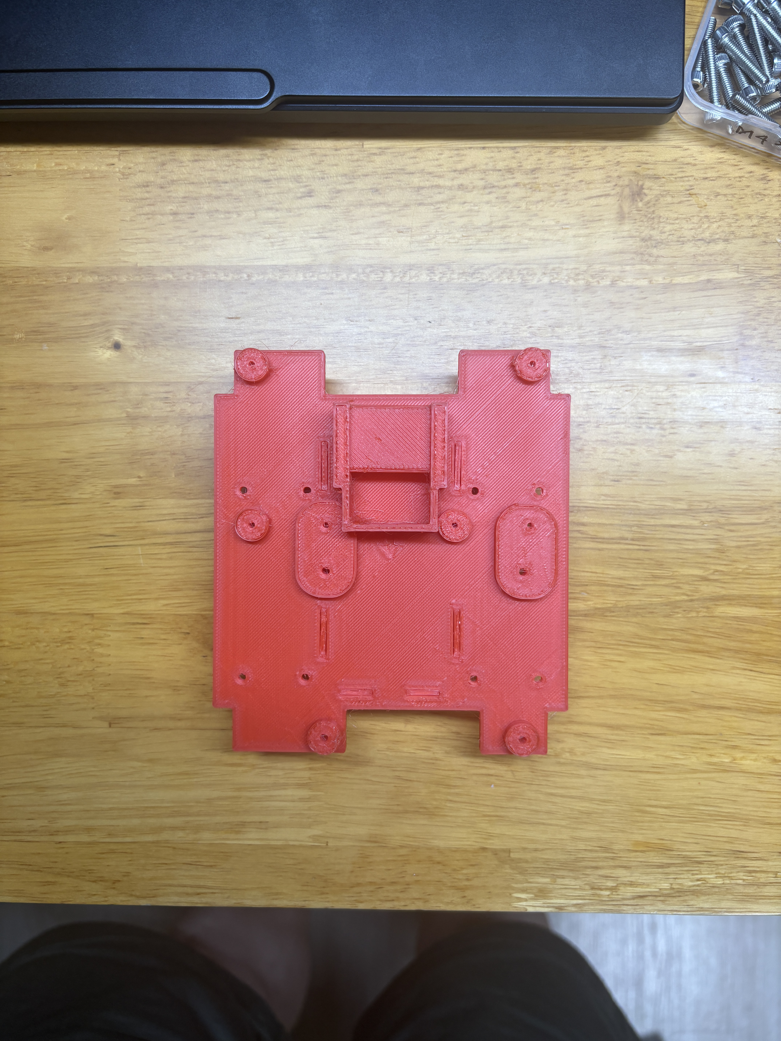
study/minho/stl/plate_rpi_front.JPG
