minodori/spotmicro-pi/study/minho/stl/plate_rpi_rear.JPG

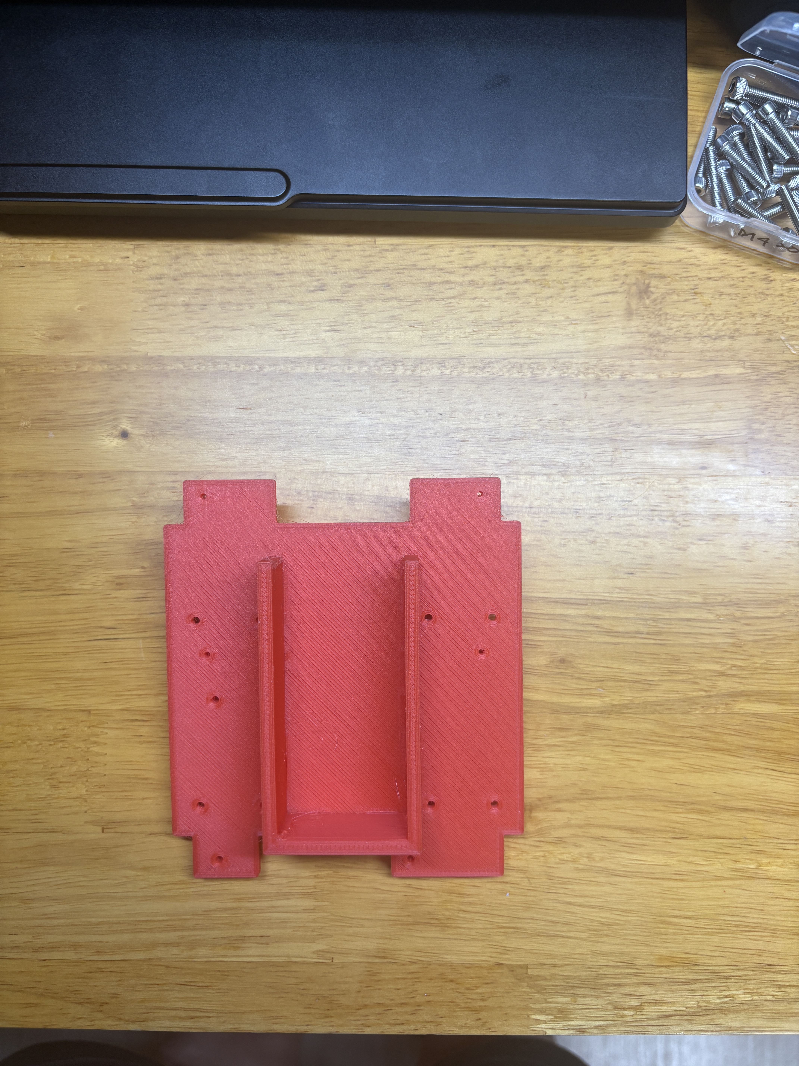
study/minho/stl/plate_rpi_rear.JPG
